Lucus16/NDL/(commit log)

2016-04-06 Added webview, arduino auto code
2016-04-06 Made auto and wheelie work with same app
